Eduardo-dlrf/Autonomous-4WD-Control-System/Core/Inc/Directions.h

/*
 * Directions.h
 *
 *  Created on: Nov 5, 2023
 *      Author: Jorge
 */

#ifndef SRC_DIRECTIONS_H_
#define SRC_DIRECTIONS_H_





#endif /* SRC_DIRECTIONS_H_ */

void Forward(void);

void RightTurn(void);

void LeftTurn(void);

void Stop(void);
